PetRover/board/README.md

# board
This repo is for keeping track of our board file

Final implementation video can be found on YouTube! 
https://youtu.be/edSjpHhAPHc
