PetRover/board/(threads)

Thread 1 (2015-09-12):

Footprint is wrong for TPS55340

brycedcarter, 2015-09-12:
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

nnewhart, 2015-09-12:
done

Closed 2015-09-12.

Thread 2 (2015-09-12):

Add power pad to TPS55340

brycedcarter, 2015-09-12:
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

nnewhart, 2015-09-12:
I remember seeing this when I was making the footprint, but wasn't sure what to connect the pad to? Is it not connected to anything? or is it exposed ground?

brycedcarter, 2015-09-12:
yes, it should be connected to AGND... but that can happen during layout. For the footprint itself, you just need to make a solder mask defined pad where the underlying copper is 5X3.4 and the exposed copper is 2.31X2.64

brycedcarter, 2015-09-12:
[here](http://eagle.support.eng.narkive.com/FxgvYbra/how-do-i-do-a-solder-mask-defined-pad-with-eagle) is a link for how to do solder mask defined pads

brycedcarter, 2015-09-19:
Done
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

Closed 2015-09-19.

Thread 4 (2015-09-12):

Choose Inductor and Diode for TPS55340 (12V0 Boost)

brycedcarter, 2015-09-12:
use pages 15-18 in the datasheet
 requirements:
- 4.5 A output current
- 12 V output voltage
- 250 mV max ripple
- 3v min input voltage
- Expected transient ??? (need to do research and testing on the motors https://github.com/PetRover/board/issues/5)

Closed 2015-09-22.

Thread 5 (2015-09-12):

Determine Transient Load Expected from Motors

brycedcarter, 2015-09-12:
Need to test motors in the lab to determine inrush current

How much can we mitigate inrush current with PWM ramped startup?
How much can we mitigate inrush current with bulk cap?

brycedcarter, 2015-09-12:
- Unloaded startup current max = **500mA**
- unloaded operating current = **100mA**
- Stall current = **1.86A**

brycedcarter, 2015-09-24:
done

Closed 2015-09-24.

Thread 7 (2015-09-12):

Motor drivers need solder mask defined pads for their power pads

brycedcarter, 2015-09-12:
[here](http://eagle.support.eng.narkive.com/FxgvYbra/how-do-i-do-a-solder-mask-defined-pad-with-eagle) is a link for how to do solder mask defined pads

brycedcarter, 2015-09-19:
Done
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

Closed 2015-09-19.

Thread 12 (2015-09-17):

STOQ023251 not wide enough

ajbezreh, 2015-09-17:
New to this software, but I think the center of the pin to the outside of the package should be 2.6mm, and it's far less than that.
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

In the image below, the grid is set to 2.6mm (my way of showing that it's not wide enough?
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

ajbezreh, 2015-09-17:
Also, does it need to be 9.2mm in the other direction? It's currently 2.4mm.
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
Not sure if these dimensions mattered, but I figured it might change spacings on the board if they're actually different.

ajbezreh, 2015-09-17:
If it is an issue, then it's also an issue with the 4 pin connector
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

brycedcarter, 2015-09-20:
fixed

Closed 2015-09-20.

Thread 13 (2015-09-17):

Spacing too small on DEA202450BT-1294C1-H

ajbezreh, 2015-09-17:
Still might be doing this wrong, but I read this as the spacing should be 0.25mm

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

and in ours, it's definitely not that big (I made the grid 0.25mm, and a grid square is definitely bigger than the gap)

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

brycedcarter, 2015-09-20:
fixed

Closed 2015-09-20.

Thread 19 (2015-09-19):

Fix bad GND current path for stepper driver

brycedcarter, 2015-09-19:
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

brycedcarter, 2015-09-24:
done
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

Closed 2015-09-24.

Thread 21 (2015-09-22):

Pin numbers need changing for BBB

ajbezreh, 2015-09-22:
They are numbered pretty weird on the BBB

brycedcarter, 2015-10-01:
confirmed fixed

Closed 2015-10-01.

Thread 23 (2015-10-01):

Need to connect the MTR_CAM_AIN1 and 2 to something

brycedcarter, 2015-10-01:
were we going to join them with the treat motor PWM?

brycedcarter, 2015-10-03:
done

brycedcarter, 2015-10-03:
connected to MTR_TREAT_IN1 and MTR_TREAT_IN2

Closed 2015-10-03.

Thread 24 (2015-10-01):

The board is going to crash into the ethernet module

brycedcarter, 2015-10-01:
There is not really anything we can do about this. My suggestion is that we buy an extra set of headers so we have some extra standoff distance

brycedcarter, 2015-12-01:
yep...

Closed 2015-12-01.

Thread 29 (2015-11-06):

Board does not boot when connected to P8

nnewhart, 2015-11-06:
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

I measured the voltages of the P8 pins and there were a couple (44, 42) with a voltage of 1.7ish. I chose to investigate since it is below the 2V threshold. I measured the pull up resistances (R65, 66, 67, 68 on the back side of the bbb) when connected to the rover board and not connected. Not connected: all were around 83kohms. Connected one was 90ish k and 3 were around 52k. I forgot to write down which were which. My current thought is maybe we have resistances in parallel to these pullups causing the resistance to decrease and the voltage drops therefore not triggering correctly? Not sure if this is a valid assumption since I'm not positive what they should be doing.

Before all of that I tried pull downs on those pins... DO NOT do that haha all four blue boot pins lit up and stayed lit but it made a screeching warning noise... my bad... but I'm confident that didn't harm anything.

Another thing I investigated was the various rails and regulators. Most looked good, however, the 12V0_SW looked a little funky coming out of the inductor. Once again, I should have taken a picture. But the output of the reg looked fine so I don't think it was a problem.

Not sure how to proceed. If we think the pull up resistances could be the problem, we could try replacing them with something greater? Just wanted to recap my steps to avoid repetition.

nnewhart, 2015-12-02:
done. pulled up r44,42,41

Closed 2015-12-02.

Thread 34 (2015-12-01):

Even without board attached, BBB only boots every few times

ajbezreh, 2015-12-01:
Currently have to plug it in to 5V supply (wall wart) multiple times with button pressed for it to boot (any of the four LEDS to turn on)
