PetRover/board/ROVER_PCB.brd

## EAGLE design ROVER_PCB.brd (2015-10-28)

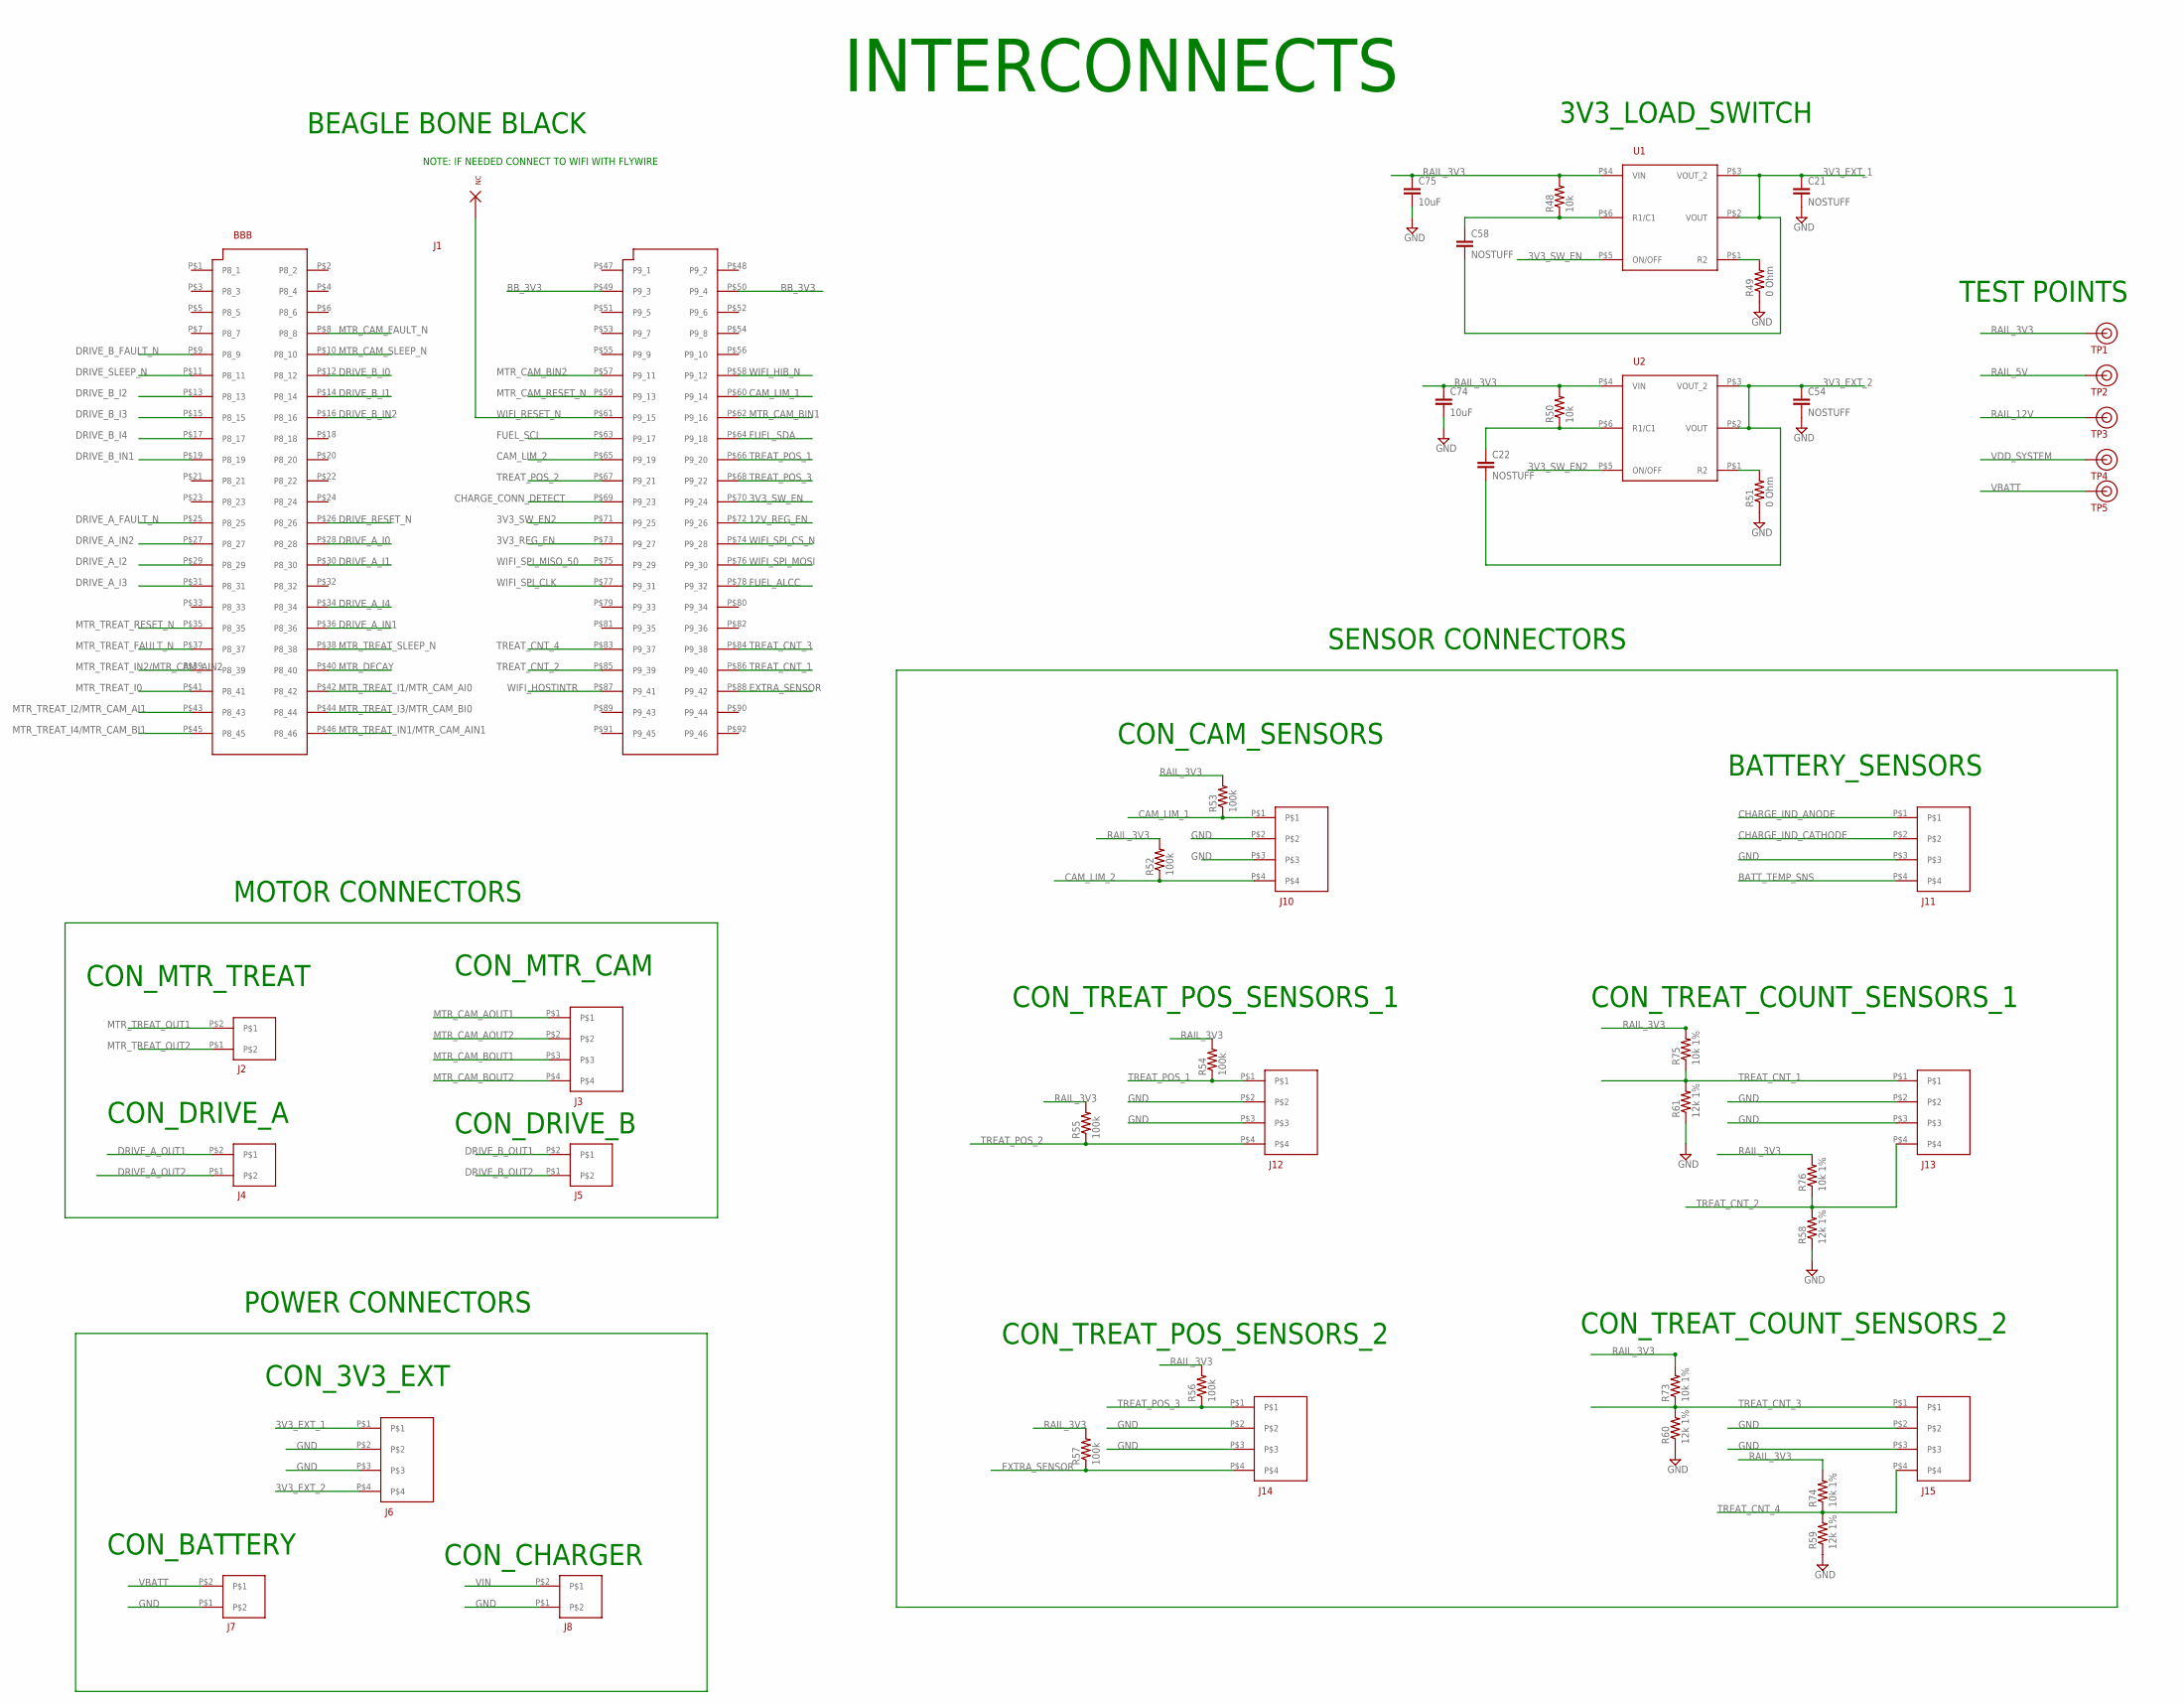
[picture p5: schematic ROVER_PCB.sch, sheet 1]

Parts:
C21, C22, C54, C58: NOSTUFF; C0402
C74, C75: 10uF; C0402
J1: NONE; BBB
J2, J4, J5, J7, J8: 2PIN_OST_3251
J3: 4PIN_OST_3251
J6, J10, J11, J12, J13, J14, J15: 4PIN_JST
R48, R50: 10k; R0603
R49, R51: 0 Ohm; R0603
R52, R53, R54, R55, R56, R57: 100k; R0603
R58, R59, R60, R61: 12k 1%; R0603
R73, R74, R75, R76: 10k 1%; R0603
TP1, TP2, TP3, TP4, TP5: TEST_POINT
U1, U2: TPS27081A

Connections:
3V3_EXT_1: C21.1, C58.2, J6.P$1, U1.P$2 (VOUT), U1.P$3 (VOUT_2)
3V3_EXT_2: C22.2, C54.1, J6.P$4, U2.P$2 (VOUT), U2.P$3 (VOUT_2)
3V3_REG_EN: J1.P$73 (P9_27); also elsewhere on the board
3V3_SW_EN: J1.P$70 (P9_24), U1.P$5 (ON/OFF)
3V3_SW_EN2: J1.P$71 (P9_25), U2.P$5 (ON/OFF)
12V_REG_EN: J1.P$72 (P9_26); also elsewhere on the board
BATT_TEMP_SNS: J11.P$4; also elsewhere on the board
BB_3V3: J1.P$49 (P9_3), J1.P$50 (P9_4); also elsewhere on the board
CAM_LIM_1: J1.P$60 (P9_14), J10.P$1, R53.1
CAM_LIM_2: J1.P$65 (P9_19), J10.P$4, R52.1
CHARGE_CONN_DETECT: J1.P$69 (P9_23); also elsewhere on the board
CHARGE_IND_ANODE: J11.P$1; also elsewhere on the board
CHARGE_IND_CATHODE: J11.P$2; also elsewhere on the board
DRIVE_A_FAULT_N: J1.P$25 (P8_25); also elsewhere on the board
DRIVE_A_I0: J1.P$28 (P8_28); also elsewhere on the board
DRIVE_A_I1: J1.P$30 (P8_30); also elsewhere on the board
DRIVE_A_I2: J1.P$29 (P8_29); also elsewhere on the board
DRIVE_A_I3: J1.P$31 (P8_31); also elsewhere on the board
DRIVE_A_I4: J1.P$34 (P8_34); also elsewhere on the board
DRIVE_A_IN1: J1.P$36 (P8_36); also elsewhere on the board
DRIVE_A_IN2: J1.P$27 (P8_27); also elsewhere on the board
DRIVE_A_OUT1: J4.P$2; also elsewhere on the board
DRIVE_A_OUT2: J4.P$1; also elsewhere on the board
DRIVE_B_FAULT_N: J1.P$9 (P8_9); also elsewhere on the board
DRIVE_B_I0: J1.P$12 (P8_12); also elsewhere on the board
DRIVE_B_I1: J1.P$14 (P8_14); also elsewhere on the board
DRIVE_B_I2: J1.P$13 (P8_13); also elsewhere on the board
DRIVE_B_I3: J1.P$15 (P8_15); also elsewhere on the board
DRIVE_B_I4: J1.P$17 (P8_17); also elsewhere on the board
DRIVE_B_IN1: J1.P$19 (P8_19); also elsewhere on the board
DRIVE_B_IN2: J1.P$16 (P8_16); also elsewhere on the board
DRIVE_B_OUT1: J5.P$2; also elsewhere on the board
DRIVE_B_OUT2: J5.P$1; also elsewhere on the board
DRIVE_RESET_N: J1.P$26 (P8_26); also elsewhere on the board
DRIVE_SLEEP_N: J1.P$11 (P8_11); also elsewhere on the board
EXTRA_SENSOR: J1.P$88 (P9_42), J14.P$4, R57.1
FUEL_ALCC: J1.P$78 (P9_32); also elsewhere on the board
FUEL_SCL: J1.P$63 (P9_17); also elsewhere on the board
FUEL_SDA: J1.P$64 (P9_18); also elsewhere on the board
GND: C21.2, C54.2, C74.2, C75.2, J6.P$2, J6.P$3, J7.P$1, J8.P$1, J10.P$2, J10.P$3, J11.P$3, J12.P$2, J12.P$3, J13.P$2, J13.P$3, J14.P$2, J14.P$3, J15.P$2, J15.P$3, R49.1, R51.1, R58.1, R59.1, R60.1, R61.1; also elsewhere on the board
MTR_CAM_AOUT1: J3.P$1; also elsewhere on the board
MTR_CAM_AOUT2: J3.P$2; also elsewhere on the board
MTR_CAM_BIN1: J1.P$62 (P9_16); also elsewhere on the board
MTR_CAM_BIN2: J1.P$57 (P9_11); also elsewhere on the board
MTR_CAM_BOUT1: J3.P$3; also elsewhere on the board
MTR_CAM_BOUT2: J3.P$4; also elsewhere on the board
MTR_CAM_FAULT_N: J1.P$8 (P8_8); also elsewhere on the board
MTR_CAM_RESET_N: J1.P$59 (P9_13); also elsewhere on the board
MTR_CAM_SLEEP_N: J1.P$10 (P8_10); also elsewhere on the board
MTR_DECAY: J1.P$40 (P8_40); also elsewhere on the board
MTR_TREAT_FAULT_N: J1.P$37 (P8_37); also elsewhere on the board
MTR_TREAT_I0: J1.P$41 (P8_41); also elsewhere on the board
MTR_TREAT_I1/MTR_CAM_AI0: J1.P$42 (P8_42); also elsewhere on the board
MTR_TREAT_I2/MTR_CAM_AI1: J1.P$43 (P8_43); also elsewhere on the board
MTR_TREAT_I3/MTR_CAM_BI0: J1.P$44 (P8_44); also elsewhere on the board
MTR_TREAT_I4/MTR_CAM_BI1: J1.P$45 (P8_45); also elsewhere on the board
MTR_TREAT_IN1/MTR_CAM_AIN1: J1.P$46 (P8_46); also elsewhere on the board
MTR_TREAT_IN2/MTR_CAM_AIN2: J1.P$39 (P8_39); also elsewhere on the board
MTR_TREAT_OUT1: J2.P$2; also elsewhere on the board
MTR_TREAT_OUT2: J2.P$1; also elsewhere on the board
MTR_TREAT_RESET_N: J1.P$35 (P8_35); also elsewhere on the board
MTR_TREAT_SLEEP_N: J1.P$38 (P8_38); also elsewhere on the board
unnamed: R49.2, U1.P$1 (R2)
unnamed: R51.2, U2.P$1 (R2)
unnamed: C58.1, R48.1, U1.P$6 (R1/C1)
unnamed: C22.1, R50.1, U2.P$6 (R1/C1)
RAIL_3V3: C74.1, C75.1, R48.2, R50.2, R52.2, R53.2, R54.2, R55.2, R56.2, R57.2, R73.2, R74.2, R75.2, R76.2, TP1.P$1, U1.P$4 (VIN), U2.P$4 (VIN); also elsewhere on the board
RAIL_5V: TP2.P$1; also elsewhere on the board
RAIL_12V: TP3.P$1; also elsewhere on the board
TREAT_CNT_1: J1.P$86 (P9_40), J13.P$1, R61.2, R75.1
TREAT_CNT_2: J1.P$85 (P9_39), J13.P$4, R58.2, R76.1
TREAT_CNT_3: J1.P$84 (P9_38), J15.P$1, R60.2, R73.1
TREAT_CNT_4: J1.P$83 (P9_37), J15.P$4, R59.2, R74.1
TREAT_POS_1: J1.P$66 (P9_20), J12.P$1, R54.1
TREAT_POS_2: J1.P$67 (P9_21), J12.P$4, R55.1
TREAT_POS_3: J1.P$68 (P9_22), J14.P$1, R56.1
VBATT: J7.P$2, TP5.P$1; also elsewhere on the board
VDD_SYSTEM: TP4.P$1; also elsewhere on the board
VIN: J8.P$2; also elsewhere on the board
WIFI_HIB_N: J1.P$58 (P9_12); also elsewhere on the board
WIFI_HOSTINTR: J1.P$87 (P9_41); also elsewhere on the board
WIFI_RESET_N: J1.P$61 (P9_15)
WIFI_SPI_CLK: J1.P$77 (P9_31); also elsewhere on the board
WIFI_SPI_CS_N: J1.P$74 (P9_28); also elsewhere on the board
WIFI_SPI_MISO_50: J1.P$75 (P9_29); also elsewhere on the board
WIFI_SPI_MOSI: J1.P$76 (P9_30); also elsewhere on the board

Notes on the sheet:
BEAGLE BONE BLACK
CON_BATTERY
CON_CHARGER
CON_DRIVE_A
CON_DRIVE_B
CON_MTR_TREAT
CON_MTR_CAM
CON_CAM_SENSORS
CON_TREAT_POS_SENSORS_1
CON_TREAT_POS_SENSORS_2
CON_TREAT_COUNT_SENSORS_2
CON_TREAT_COUNT_SENSORS_1
CON_3V3_EXT
3V3_LOAD_SWITCH
NOTE: IF NEEDED CONNECT TO WIFI WITH FLYWIRE
TEST POINTS
BATTERY_SENSORS
INTERCONNECTS
POWER CONNECTORS
MOTOR CONNECTORS
SENSOR CONNECTORS

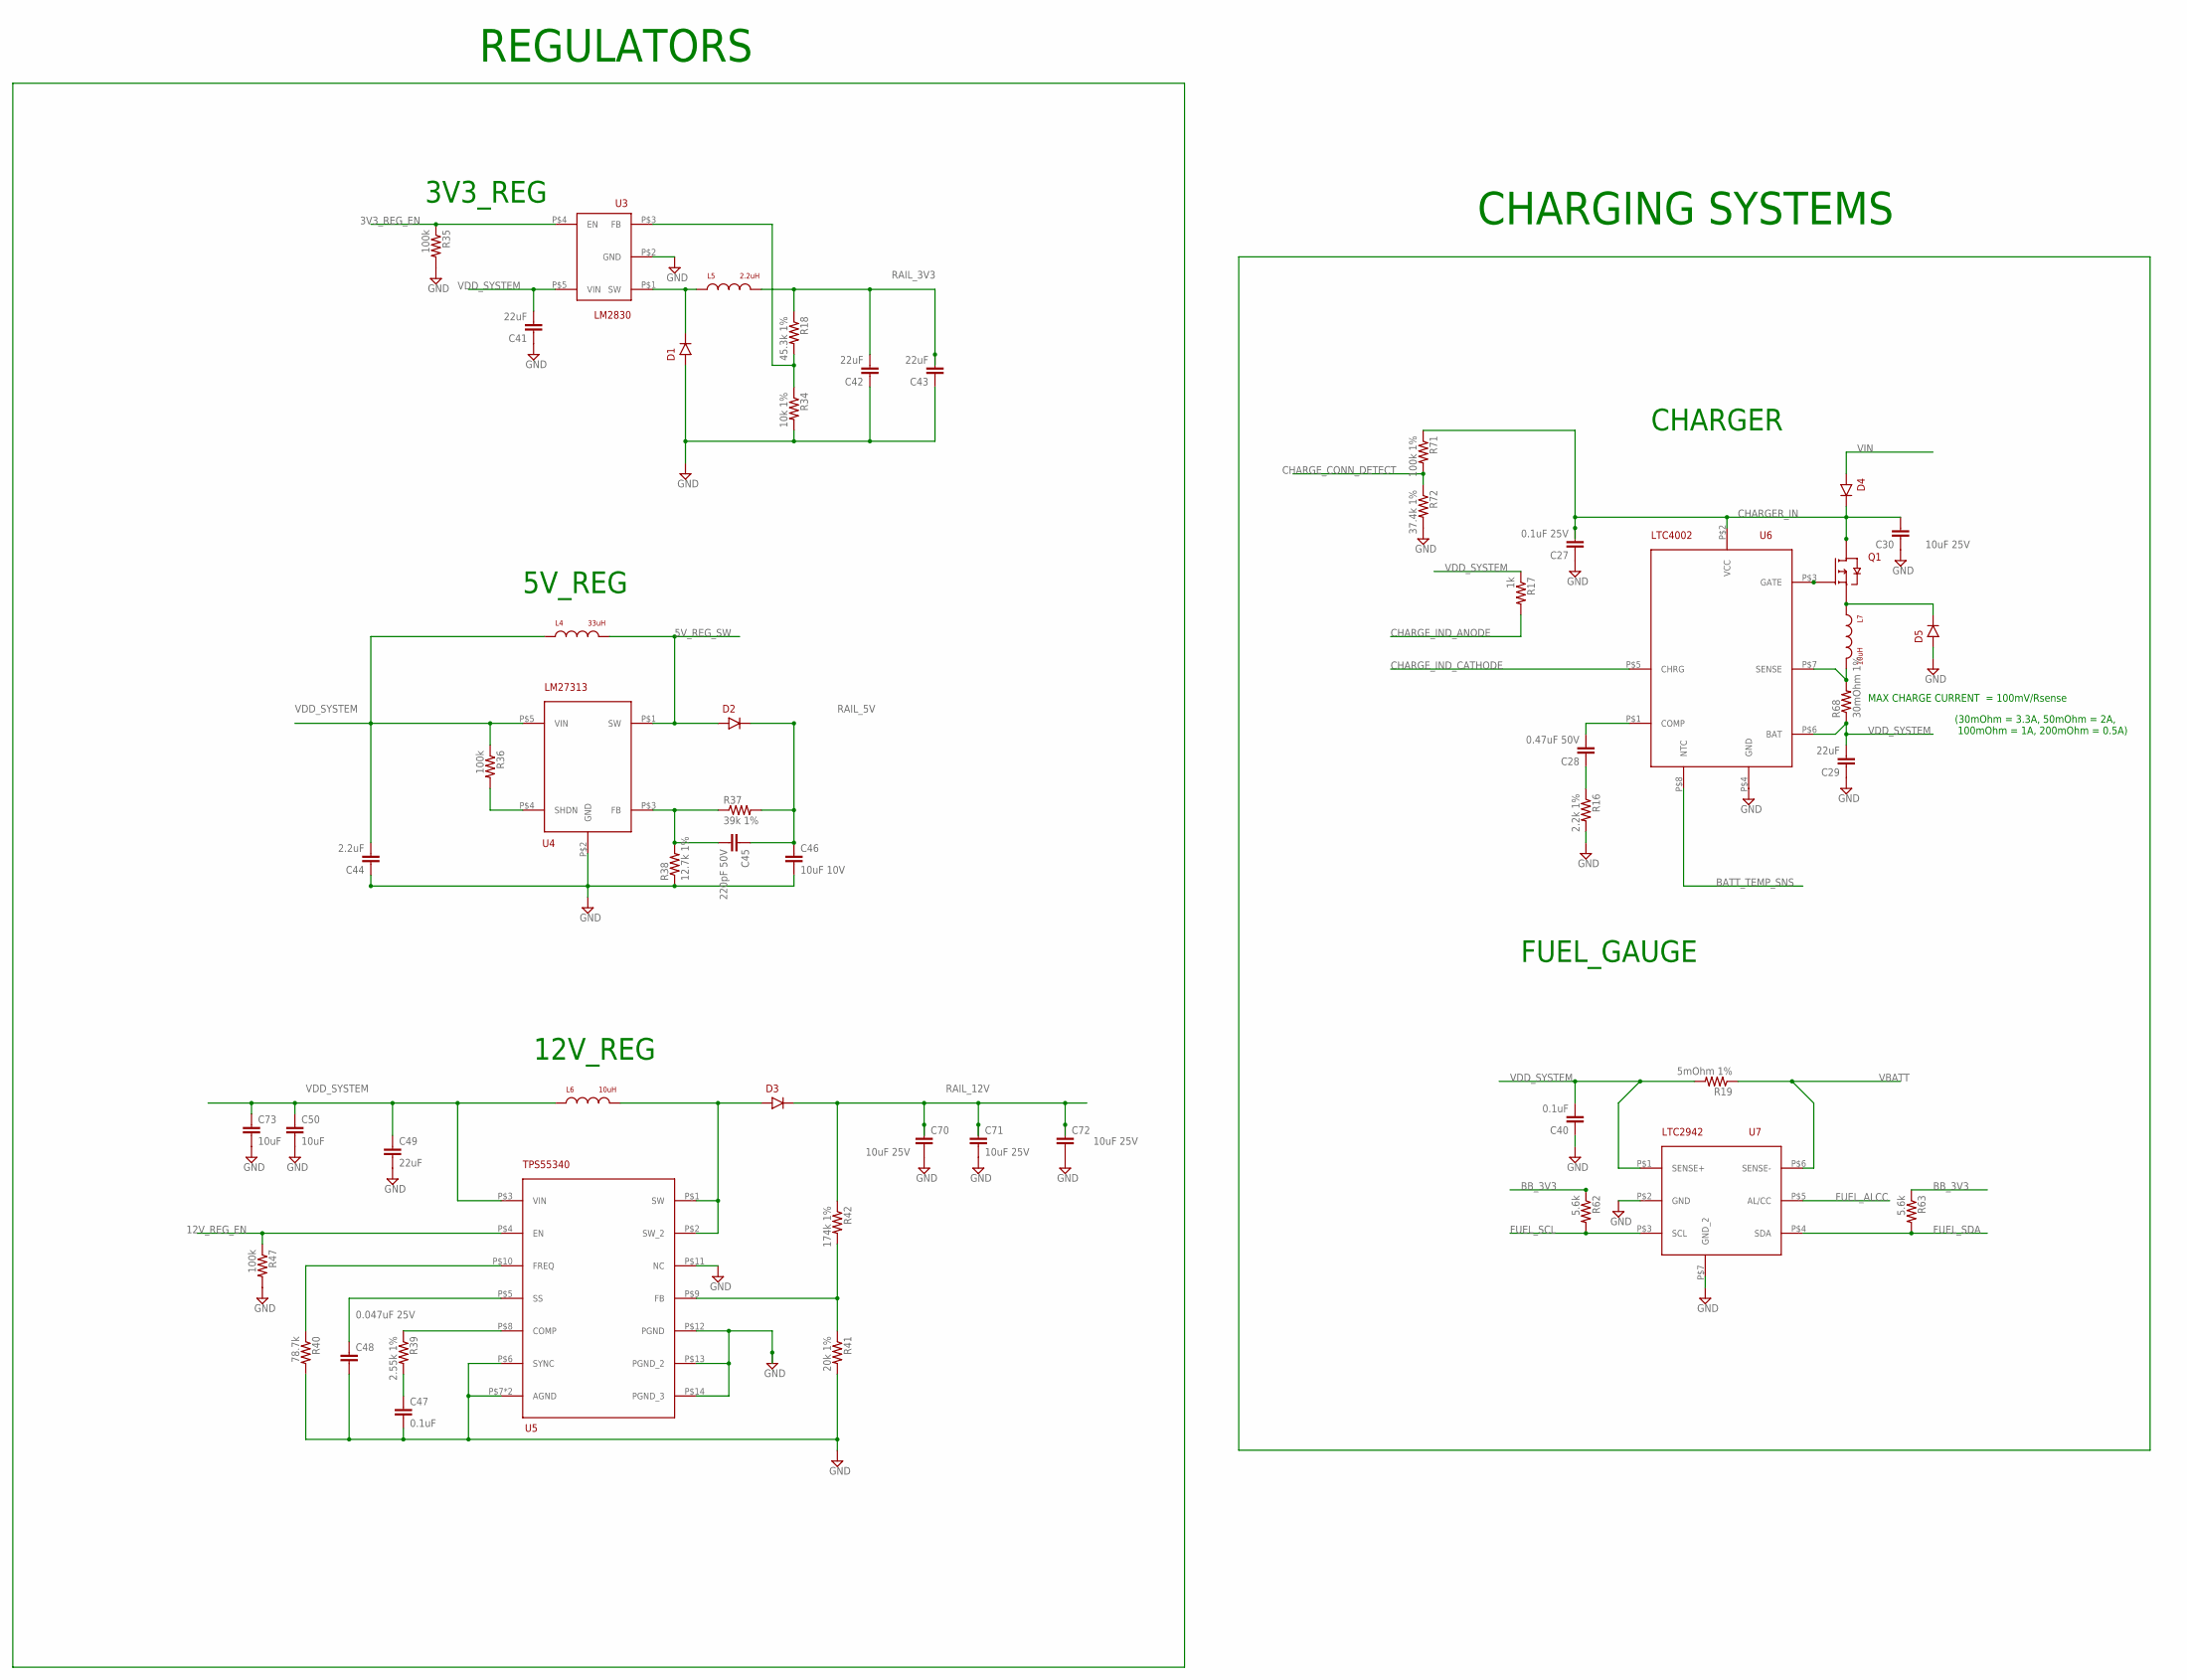
[picture p6: schematic ROVER_PCB.sch, sheet 2]

Parts:
C27: 0.1uF 25V; C0603
C28: 0.47uF 50V; C0603
C29, C41, C42, C43, C49: 22uF; C0603
C30, C70, C71, C72: 10uF 25V; C0603
C40, C47: 0.1uF; C0603
C44: 2.2uF; C0603
C45: 220pF 50V; C0603
C46: 10uF 10V; C0603
C48: 0.047uF 25V; C0603
C50, C73: 10uF; C0402
D1: CRS08
D2: MBR0520; MBR05XX
D3, D4, D5: B540C
L4: 33uH; AIUR-03
L5: 2.2uH; B82144B2222K
L6, L7: 10uH; ASPI-0630LR
Q1: AO3407A; SOT23
R16: 2.2k 1%; R0603
R17: 1k; R0603
R18: 45.3k 1%; R0603
R19: 5mOhm 1%; R2512
R34: 10k 1%; R0603
R35, R36, R47: 100k; R0603
R37: 39k 1%; R0603
R38: 12.7k 1%; R0603
R39: 2.55k 1%; R0603
R40: 78.7k; R0603
R41: 20k 1%; R0402
R42: 174k 1%; R0402
R62, R63: 5.6k; R0603
R68: 30mOhm 1%; R2512
R71: 100k 1%; R0603
R72: 37.4k 1%; R0603
U3: LM2830
U4: LM27313; LM2830
U5: TPS55340
U6: LTC4002
U7: LTC2942

Connections:
3V3_REG_EN: R35.1, U3.P$4 (EN); also elsewhere on the board
3V3_SW: D1.P$2, L5.P$1, U3.P$1 (SW)
5V_REG_SW: D2.P$1, L4.P$2, U4.P$1 (SW)
12V0_SW: D3.P$1, L6.P$2, U5.P$1 (SW), U5.P$2 (SW_2)
12V_REG_EN: R47.1, U5.P$4 (EN); also elsewhere on the board
BATT_TEMP_SNS: U6.P$8 (NTC); also elsewhere on the board
BB_3V3: R62.1, R63.1; also elsewhere on the board
CATCH_DIODE_CATHODE: D5.P$2, L7.P$1, Q1.2 (SOURE)
CHARGER_IN: C27.2, C30.2, D4.P$2, Q1.3 (DRAIN), R71.1, U6.P$2 (VCC)
CHARGE_CONN_DETECT: R71.2, R72.1; also elsewhere on the board
CHARGE_IND_ANODE: R17.2; also elsewhere on the board
CHARGE_IND_CATHODE: U6.P$5 (CHRG); also elsewhere on the board
CHARGE_SENSE_HI_SIDE: L7.P$2, R68.2, U6.P$7 (SENSE)
FUEL_ALCC: U7.P$5 (AL/CC); also elsewhere on the board
FUEL_SCL: R62.2, U7.P$3 (SCL); also elsewhere on the board
FUEL_SDA: R63.2, U7.P$4 (SDA); also elsewhere on the board
GND: C27.1, C29.1, C30.1, C40.1, C41.1, C42.1, C43.1, C44.1, C46.2, C47.2, C48.2, C49.2, C50.2, C70.2, C71.2, C72.2, C73.2, D1.P$1, D5.P$1, R16.2, R34.2, R35.2, R38.1, R40.2, R41.2, R47.2, R72.2, U3.P$2 (GND), U4.P$2 (GND), U5.P$6 (SYNC), U5.P$7 (AGND), U5.P$11 (NC), U5.P$12 (PGND), U5.P$13 (PGND_2), U5.P$14 (PGND_3), U5.P$15 (AGND), U6.P$4 (GND), U7.P$2 (GND), U7.P$7 (GND_2); also elsewhere on the board
unnamed: Q1.1 (GATE), U6.P$3 (GATE)
unnamed: C28.1, R16.1
unnamed: C28.2, U6.P$1 (COMP)
unnamed: R18.2, R34.1, U3.P$3 (FB)
unnamed: R39.1, U5.P$8 (COMP)
unnamed: C47.1, R39.2
unnamed: C48.1, U5.P$5 (SS)
unnamed: C45.2, R37.1, R38.2, U4.P$3 (FB)
unnamed: R40.1, U5.P$10 (FREQ)
unnamed: R41.1, R42.2, U5.P$9 (FB)
unnamed: R36.2, U4.P$4 (SHDN)
RAIL_3V3: C42.2, C43.2, L5.P$2, R18.1; also elsewhere on the board
RAIL_5V: C45.1, C46.1, D2.P$2, R37.2; also elsewhere on the board
RAIL_12V: C70.1, C71.1, C72.1, D3.P$2, R42.1; also elsewhere on the board
VBATT: R19.1, U7.P$6 (SENSE-); also elsewhere on the board
VDD_SYSTEM: C29.2, C40.2, C41.2, C44.2, C49.1, C50.1, C73.1, L4.P$1, L6.P$1, R17.1, R19.2, R36.1, R68.1, U3.P$5 (VIN), U4.P$5 (VIN), U5.P$3 (VIN), U6.P$6 (BAT), U7.P$1 (SENSE+); also elsewhere on the board
VIN: D4.P$1; also elsewhere on the board

Notes on the sheet:
3V3_REG
5V_REG
12V_REG
CHARGER
FUEL_GAUGE
MAX CHARGE CURRENT = 100mV/Rsense
REGULATORS
CHARGING SYSTEMS
(30mOhm = 3.3A, 50mOhm = 2A, 100mOhm = 1A, 200mOhm = 0.5A)

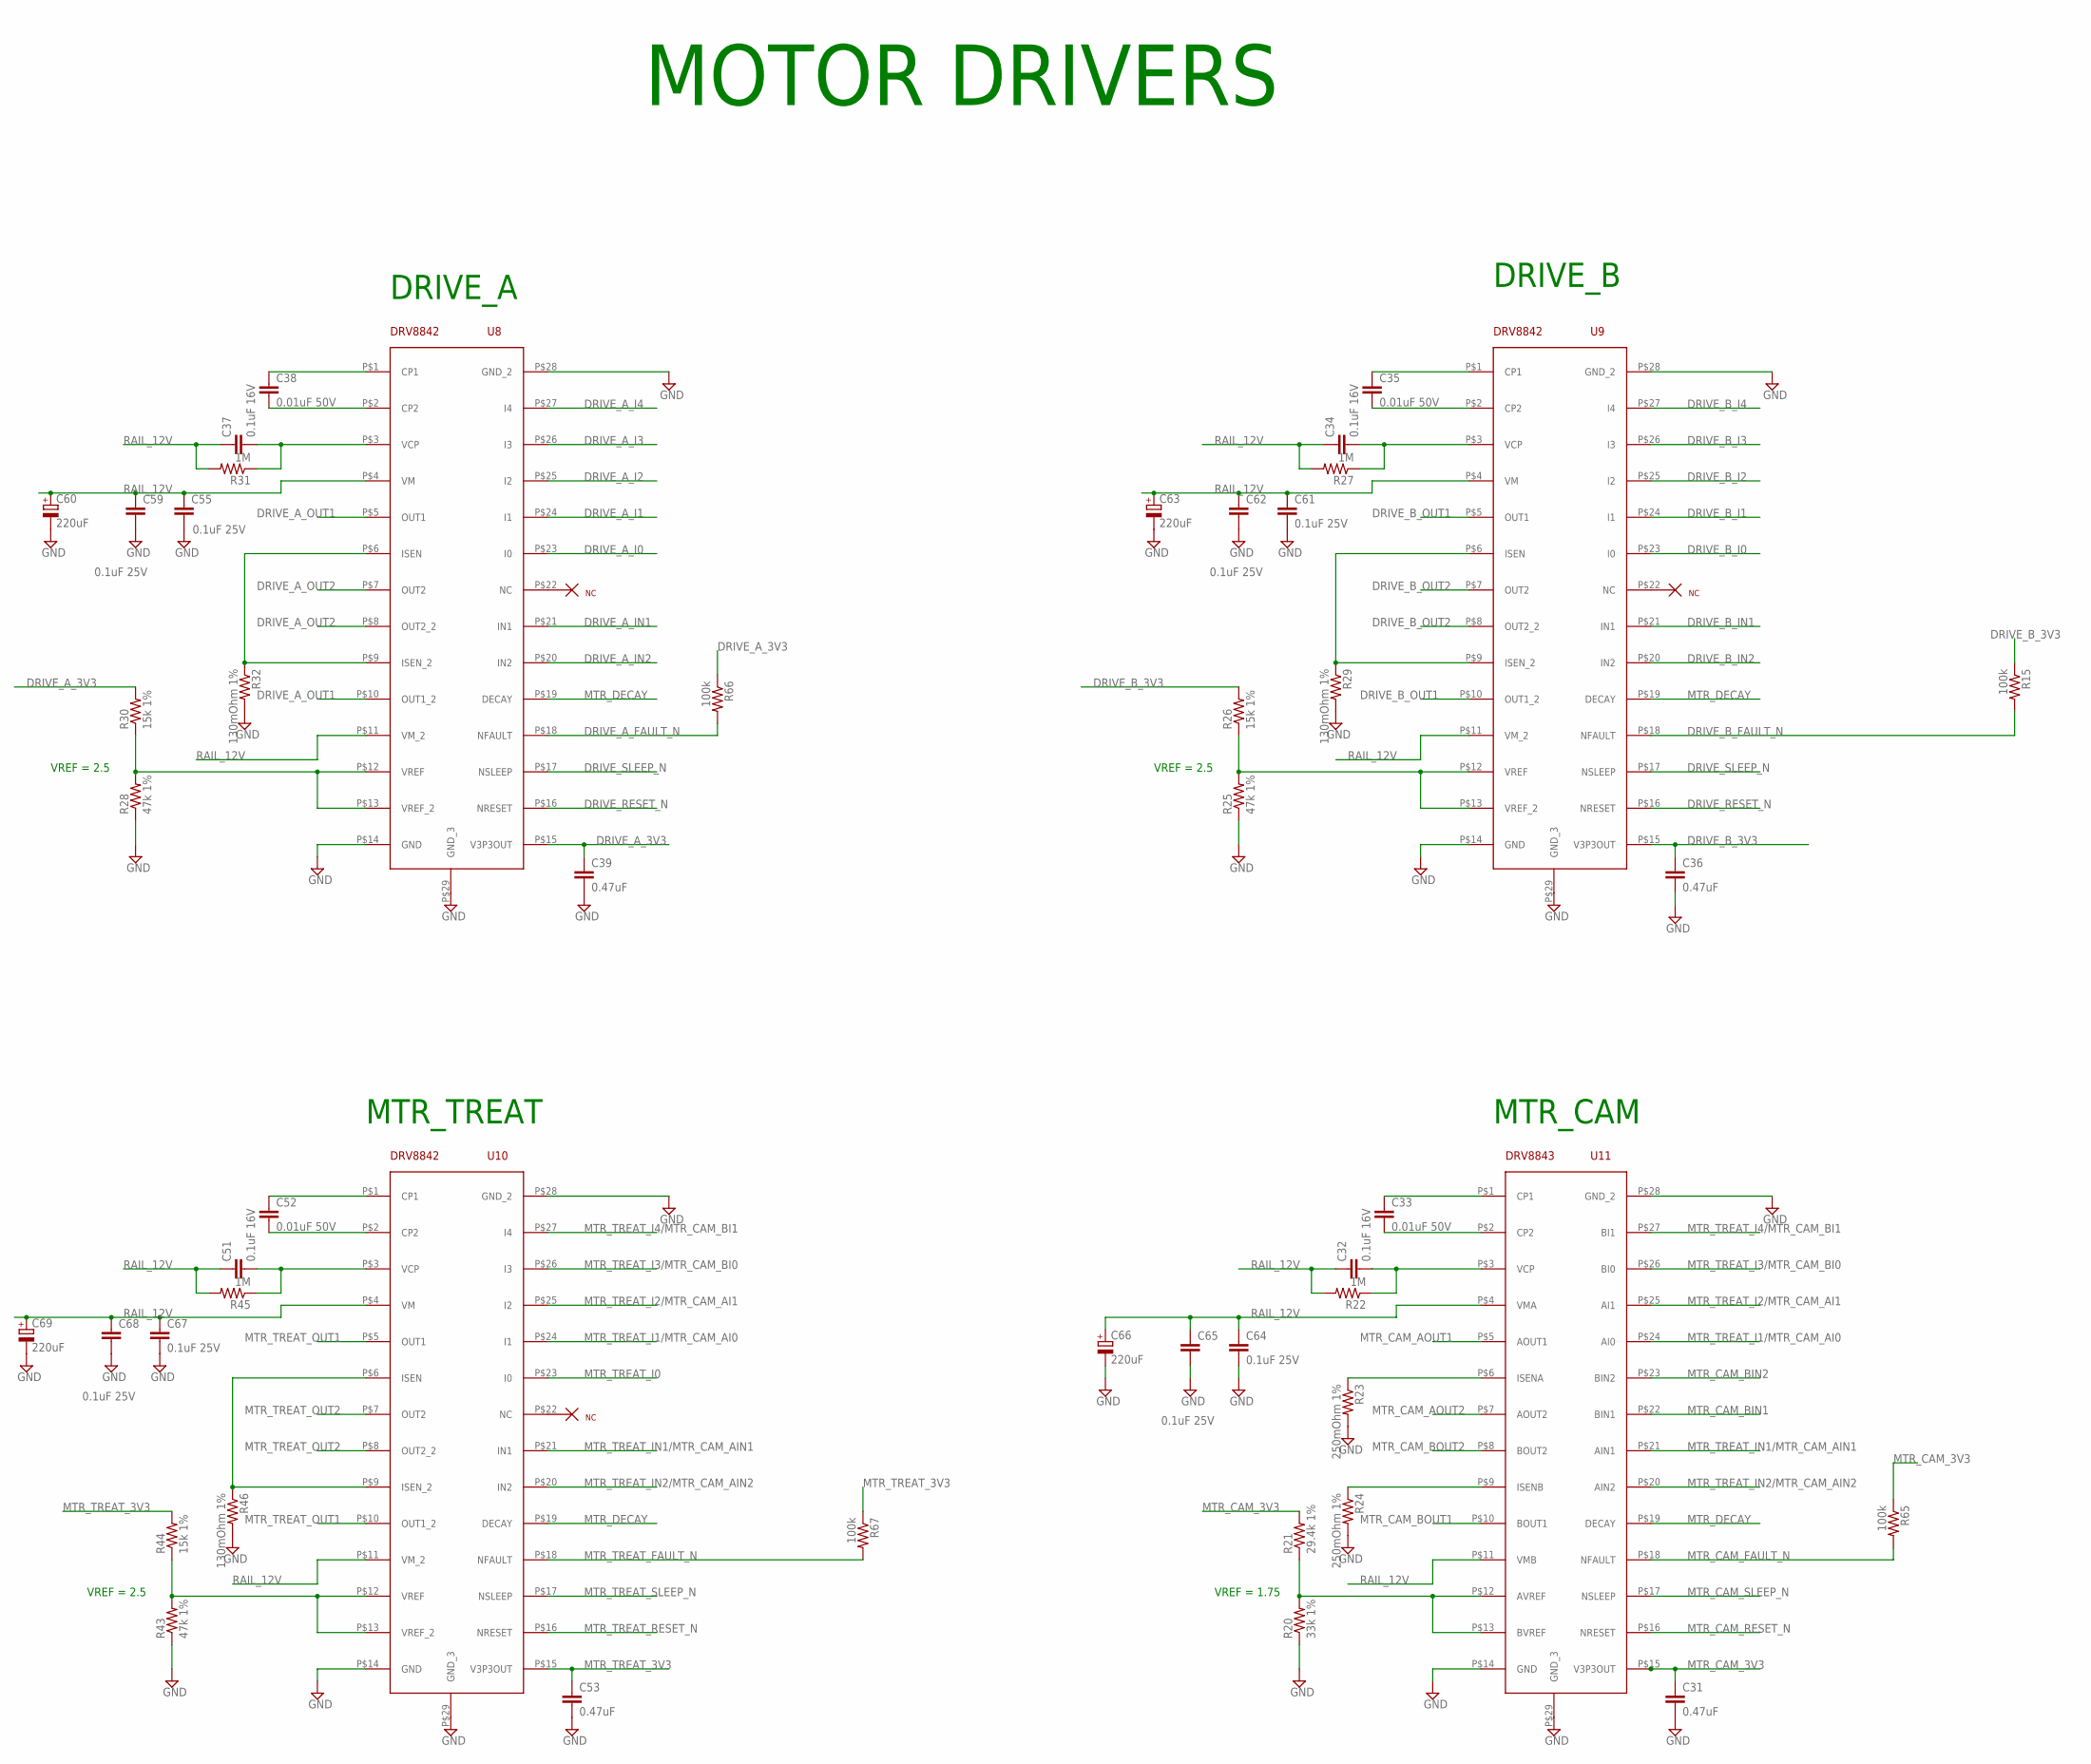
[picture p7: schematic ROVER_PCB.sch, sheet 3]

Parts:
C31, C36, C39, C53: 0.47uF; C0402
C32, C34, C37, C51: 0.1uF 16V; C0402
C33, C35, C38, C52: 0.01uF 50V; C0402
C55, C59, C61, C62, C64, C65, C67, C68: 0.1uF 25V; C0402
C60, C63, C66, C69: 220uF; E5-6
R15, R65, R66, R67: 100k; R0402
R20: 33k 1%; R0402
R21: 29.4k 1%; R0402
R22, R27, R31, R45: 1M; R0402
R23, R24: 250mOhm 1%; R1206
R25, R28, R43: 47k 1%; R0402
R26, R30, R44: 15k 1%; R0402
R29, R32, R46: 130mOhm 1%; R2512
U8, U9, U10: DRV8842
U11: DRV8843; DRV8842

Connections:
DRIVE_A_3V3: C39.1, R30.2, R66.1, U8.P$15 (V3P3OUT)
DRIVE_A_FAULT_N: R66.2, U8.P$18 (NFAULT); also elsewhere on the board
DRIVE_A_I0: U8.P$23 (I0); also elsewhere on the board
DRIVE_A_I1: U8.P$24 (I1); also elsewhere on the board
DRIVE_A_I2: U8.P$25 (I2); also elsewhere on the board
DRIVE_A_I3: U8.P$26 (I3); also elsewhere on the board
DRIVE_A_I4: U8.P$27 (I4); also elsewhere on the board
DRIVE_A_IN1: U8.P$21 (IN1); also elsewhere on the board
DRIVE_A_IN2: U8.P$20 (IN2); also elsewhere on the board
DRIVE_A_OUT1: U8.P$5 (OUT1), U8.P$10 (OUT1_2); also elsewhere on the board
DRIVE_A_OUT2: U8.P$7 (OUT2), U8.P$8 (OUT2_2); also elsewhere on the board
DRIVE_B_3V3: C36.1, R15.1, R26.2, U9.P$15 (V3P3OUT)
DRIVE_B_FAULT_N: R15.2, U9.P$18 (NFAULT); also elsewhere on the board
DRIVE_B_I0: U9.P$23 (I0); also elsewhere on the board
DRIVE_B_I1: U9.P$24 (I1); also elsewhere on the board
DRIVE_B_I2: U9.P$25 (I2); also elsewhere on the board
DRIVE_B_I3: U9.P$26 (I3); also elsewhere on the board
DRIVE_B_I4: U9.P$27 (I4); also elsewhere on the board
DRIVE_B_IN1: U9.P$21 (IN1); also elsewhere on the board
DRIVE_B_IN2: U9.P$20 (IN2); also elsewhere on the board
DRIVE_B_OUT1: U9.P$5 (OUT1), U9.P$10 (OUT1_2); also elsewhere on the board
DRIVE_B_OUT2: U9.P$7 (OUT2), U9.P$8 (OUT2_2); also elsewhere on the board
DRIVE_RESET_N: U8.P$16 (NRESET), U9.P$16 (NRESET); also elsewhere on the board
DRIVE_SLEEP_N: U8.P$17 (NSLEEP), U9.P$17 (NSLEEP); also elsewhere on the board
GND: C31.2, C36.2, C39.2, C53.2, C55.2, C59.2, C60.-, C61.2, C62.2, C63.-, C64.2, C65.2, C66.-, C67.2, C68.2, C69.-, R20.1, R23.2, R24.2, R25.1, R28.1, R29.2, R32.2, R43.1, R46.2, U8.P$14 (GND), U8.P$28 (GND_2), U8.P$29 (GND_3), U9.P$14 (GND), U9.P$28 (GND_2), U9.P$29 (GND_3), U10.P$14 (GND), U10.P$28 (GND_2), U10.P$29 (GND_3), U11.P$14 (GND), U11.P$28 (GND_2), U11.P$29 (GND_3); also elsewhere on the board
MTR_CAM_3V3: C31.1, R21.2, R65.1, U11.P$15 (V3P3OUT)
MTR_CAM_AOUT1: U11.P$5 (AOUT1); also elsewhere on the board
MTR_CAM_AOUT2: U11.P$7 (AOUT2); also elsewhere on the board
MTR_CAM_BIN1: U11.P$22 (BIN1); also elsewhere on the board
MTR_CAM_BIN2: U11.P$23 (BIN2); also elsewhere on the board
MTR_CAM_BOUT1: U11.P$10 (BOUT1); also elsewhere on the board
MTR_CAM_BOUT2: U11.P$8 (BOUT2); also elsewhere on the board
MTR_CAM_FAULT_N: R65.2, U11.P$18 (NFAULT); also elsewhere on the board
MTR_CAM_RESET_N: U11.P$16 (NRESET); also elsewhere on the board
MTR_CAM_SLEEP_N: U11.P$17 (NSLEEP); also elsewhere on the board
MTR_DECAY: U8.P$19 (DECAY), U9.P$19 (DECAY), U10.P$19 (DECAY), U11.P$19 (DECAY); also elsewhere on the board
MTR_TREAT_3V3: C53.1, R44.2, R67.1, U10.P$15 (V3P3OUT)
MTR_TREAT_FAULT_N: R67.2, U10.P$18 (NFAULT); also elsewhere on the board
MTR_TREAT_I0: U10.P$23 (I0); also elsewhere on the board
MTR_TREAT_I1/MTR_CAM_AI0: U10.P$24 (I1), U11.P$24 (AI0); also elsewhere on the board
MTR_TREAT_I2/MTR_CAM_AI1: U10.P$25 (I2), U11.P$25 (AI1); also elsewhere on the board
MTR_TREAT_I3/MTR_CAM_BI0: U10.P$26 (I3), U11.P$26 (BI0); also elsewhere on the board
MTR_TREAT_I4/MTR_CAM_BI1: U10.P$27 (I4), U11.P$27 (BI1); also elsewhere on the board
MTR_TREAT_IN1/MTR_CAM_AIN1: U10.P$21 (IN1), U11.P$21 (AIN1); also elsewhere on the board
MTR_TREAT_IN2/MTR_CAM_AIN2: U10.P$20 (IN2), U11.P$20 (AIN2); also elsewhere on the board
MTR_TREAT_OUT1: U10.P$5 (OUT1), U10.P$10 (OUT1_2); also elsewhere on the board
MTR_TREAT_OUT2: U10.P$7 (OUT2), U10.P$8 (OUT2_2); also elsewhere on the board
MTR_TREAT_RESET_N: U10.P$16 (NRESET); also elsewhere on the board
MTR_TREAT_SLEEP_N: U10.P$17 (NSLEEP); also elsewhere on the board
unnamed: R43.2, R44.1, U10.P$12 (VREF), U10.P$13 (VREF_2)
unnamed: C52.1, U10.P$1 (CP1)
unnamed: C52.2, U10.P$2 (CP2)
unnamed: R46.1, U10.P$6 (ISEN), U10.P$9 (ISEN_2)
unnamed: C51.2, R45.1, U10.P$3 (VCP)
unnamed: R20.2, R21.1, U11.P$12 (AVREF), U11.P$13 (BVREF)
unnamed: C33.1, U11.P$1 (CP1)
unnamed: C33.2, U11.P$2 (CP2)
unnamed: R23.1, U11.P$6 (ISENA)
unnamed: R24.1, U11.P$9 (ISENB)
unnamed: C32.2, R22.1, U11.P$3 (VCP)
unnamed: R28.2, R30.1, U8.P$12 (VREF), U8.P$13 (VREF_2)
unnamed: R25.2, R26.1, U9.P$12 (VREF), U9.P$13 (VREF_2)
unnamed: C35.1, U9.P$1 (CP1)
unnamed: C35.2, U9.P$2 (CP2)
unnamed: R29.1, U9.P$6 (ISEN), U9.P$9 (ISEN_2)
unnamed: C38.1, U8.P$1 (CP1)
unnamed: C34.2, R27.1, U9.P$3 (VCP)
unnamed: C38.2, U8.P$2 (CP2)
unnamed: R32.1, U8.P$6 (ISEN), U8.P$9 (ISEN_2)
unnamed: C37.2, R31.1, U8.P$3 (VCP)
RAIL_12V: C32.1, C34.1, C37.1, C51.1, C55.1, C59.1, C60.+, C61.1, C62.1, C63.+, C64.1, C65.1, C66.+, C67.1, C68.1, C69.+, R22.2, R27.2, R31.2, R45.2, U8.P$4 (VM), U8.P$11 (VM_2), U9.P$4 (VM), U9.P$11 (VM_2), U10.P$4 (VM), U10.P$11 (VM_2), U11.P$4 (VMA), U11.P$11 (VMB); also elsewhere on the board

Notes on the sheet:
DRIVE_A
DRIVE_B
MTR_TREAT
MTR_CAM
MOTOR DRIVERS
VREF = 1.75
VREF = 2.5
