PetRover/board/ROVER_PCB.brd

## EAGLE design ROVER_PCB.brd (continued)

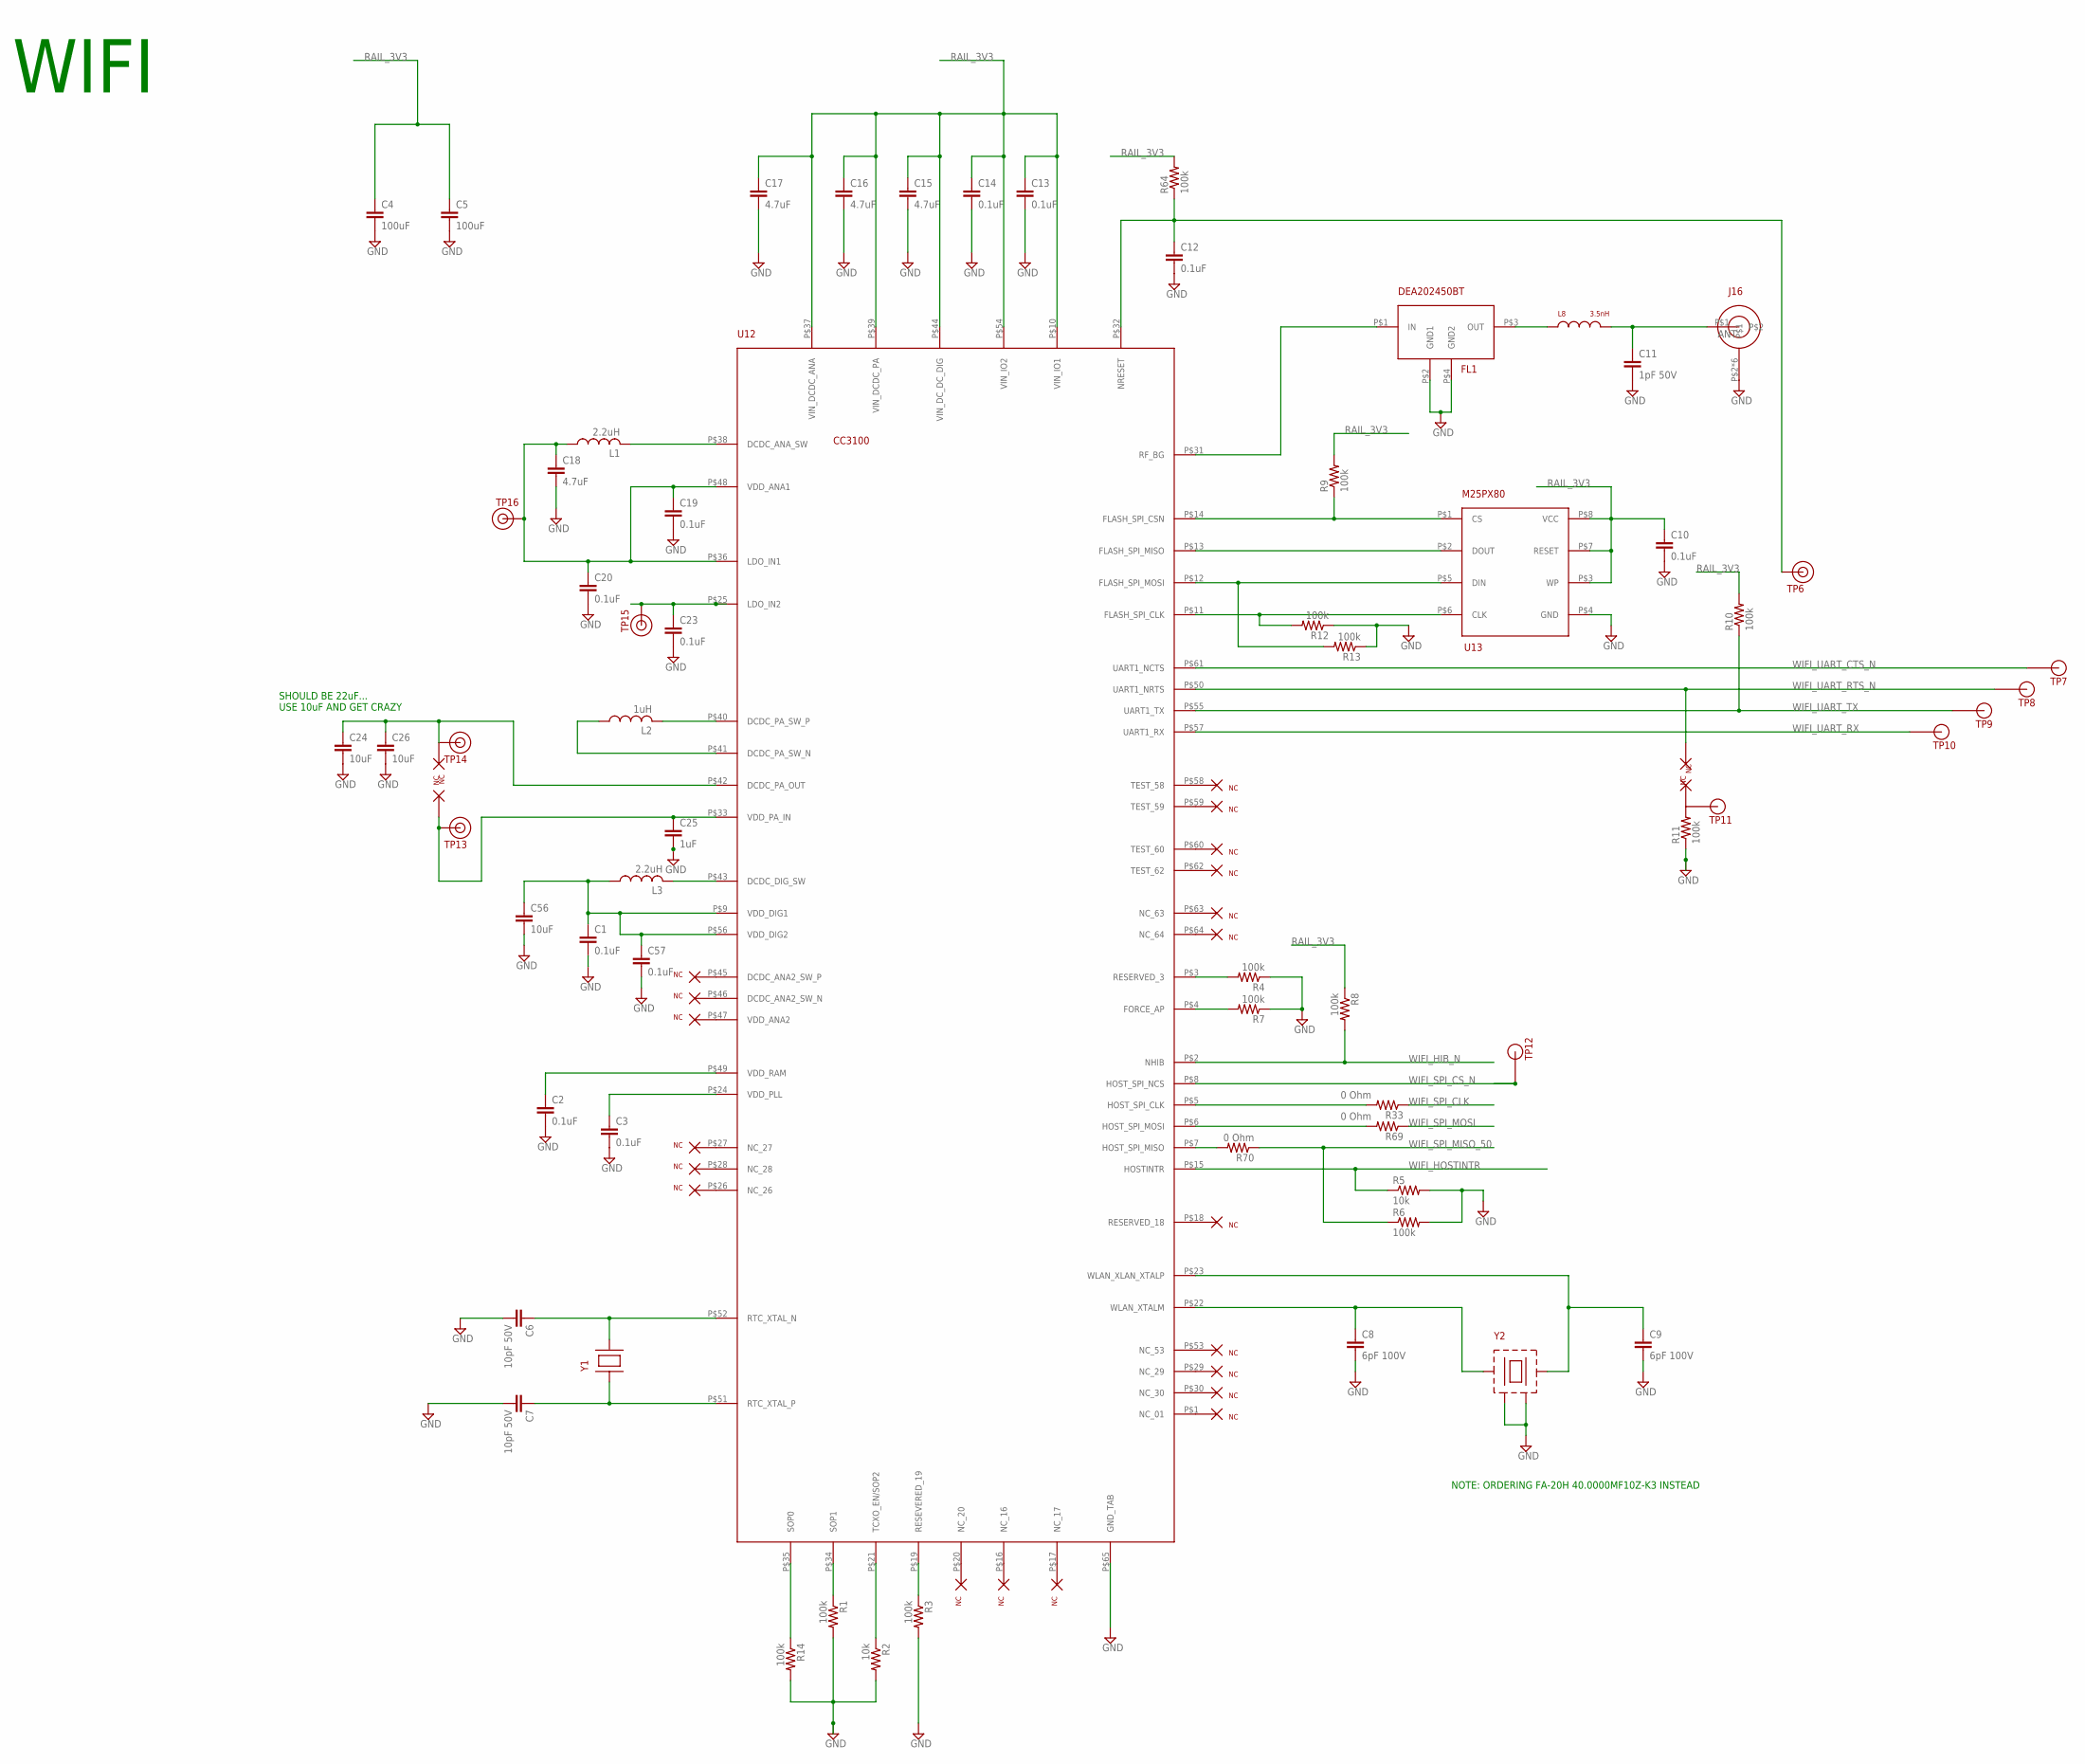
[picture p8: schematic ROVER_PCB.sch, sheet 4]

Parts:
C1, C3, C10, C12, C13, C14, C19, C20, C23, C57: 0.1uF; C0402
C2: 0.1uF; C0603
C4, C5: 100uF; C1206
C6, C7: 10pF 50V; C0402
C8, C9: 6pF 100V; C0402
C11: 1pF 50V; C0402
C15, C16, C17, C18: 4.7uF; C0402
C24, C26: 10uF; C0402
C25: 1uF; C0402
C56: 10uF; C0603
FL1: DEA202450BT
J16: SMA_CONNECTOR
L1, L3: 2.2uH; L1812
L2: 1uH; L1812
L8: 3.5nH; L0402
R1, R3, R4, R6, R7, R8, R9, R11, R12, R13, R14, R64: 100k; R0603
R2, R5: 10k; R0603
R10: 100k; R0402
R33, R69, R70: 0 Ohm; R0402
TP6, TP13, TP14, TP15, TP16: TEST_POINT
TP7, TP8, TP9, TP10, TP11, TP12: TP25MIL
U12: CC3100CORRECT_QFN; QFN64
U13: M25PX80; SO8N
Y1: ABS07-32.768KHZ-T
Y2: Q24FA20H00396

Connections:
ANT: C11.1, J16.P$1, L8.2
GND: C1.2, C2.2, C3.2, C4.2, C5.2, C6.2, C7.2, C8.2, C9.2, C10.2, C11.2, C12.2, C13.2, C14.2, C15.2, C16.2, C17.2, C18.2, C19.2, C20.2, C23.2, C24.2, C25.2, C26.2, C56.2, C57.2, FL1.P$2 (GND1), FL1.P$4 (GND2), J16.P$2, J16.P$3, J16.P$4, J16.P$5, J16.P$6, J16.P$7, R1.2, R2.2, R3.2, R4.1, R5.2, R6.2, R7.1, R11.1, R12.1, R13.1, R14.2, U12.P$65 (GND_TAB), U13.P$4 (GND), Y2.P$2, Y2.P$4; also elsewhere on the board
unnamed: C24.1, C26.1, TP14.P$1, U12.P$42 (DCDC_PA_OUT)
unnamed: C18.1, C19.1, C20.1, L1.1, TP16.P$1, U12.P$36 (LDO_IN1), U12.P$48 (VDD_ANA1)
unnamed: L3.2, U12.P$43 (DCDC_DIG_SW)
unnamed: C1.1, C56.1, C57.1, L3.1, U12.P$9 (VDD_DIG1), U12.P$56 (VDD_DIG2)
unnamed: C2.1, U12.P$49 (VDD_RAM)
unnamed: L1.2, U12.P$38 (DCDC_ANA_SW)
unnamed: L2.2, U12.P$40 (DCDC_PA_SW_P)
unnamed: L2.1, U12.P$41 (DCDC_PA_SW_N)
unnamed: C3.1, U12.P$24 (VDD_PLL)
unnamed: R14.1, U12.P$35 (SOP0)
unnamed: R1.1, U12.P$34 (SOP1)
unnamed: R2.1, U12.P$21 (TCXO_EN/SOP2)
unnamed: R3.1, U12.P$19 (RESEVERED_19)
unnamed: C8.1, U12.P$22 (WLAN_XTALM), Y2.P$1
unnamed: C9.1, U12.P$23 (WLAN_XLAN_XTALP), Y2.P$3
unnamed: C7.1, U12.P$51 (RTC_XTAL_P), Y1.P$1
unnamed: C6.1, U12.P$52 (RTC_XTAL_N), Y1.P$2
unnamed: R7.2, U12.P$4 (FORCE_AP)
unnamed: R4.2, U12.P$3 (RESERVED_3)
unnamed: R9.1, U12.P$14 (FLASH_SPI_CSN), U13.P$1 (CS)
unnamed: U12.P$13 (FLASH_SPI_MISO), U13.P$2 (DOUT)
unnamed: R13.2, U12.P$12 (FLASH_SPI_MOSI), U13.P$5 (DIN)
unnamed: R12.2, U12.P$11 (FLASH_SPI_CLK), U13.P$6 (CLK)
unnamed: FL1.P$1 (IN), U12.P$31 (RF_BG)
unnamed: FL1.P$3 (OUT), L8.1
unnamed: R11.2, TP11.P$1
unnamed: C25.1, TP13.P$1, U12.P$33 (VDD_PA_IN)
RAIL_3V3: C4.1, C5.1, C10.1, C13.1, C14.1, C15.1, C16.1, C17.1, R8.1, R9.2, R10.2, R64.2, U12.P$10 (VIN_IO1), U12.P$37 (VIN_DCDC_ANA), U12.P$39 (VIN_DCDC_PA), U12.P$44 (VIN_DC_DC_DIG), U12.P$54 (VIN_IO2), U13.P$3 (WP), U13.P$7 (RESET), U13.P$8 (VCC); also elsewhere on the board
U13: C23.1, TP15.P$1, U12.P$25 (LDO_IN2)
WIFI_HIB_N: R8.2, U12.P$2 (NHIB); also elsewhere on the board
WIFI_HOSTINTR: R5.1, U12.P$15 (HOSTINTR); also elsewhere on the board
WIFI_RESET_N_WIFI: C12.1, R64.1, TP6.P$1, U12.P$32 (NRESET)
WIFI_SPI_CLK: R33.1; also elsewhere on the board
WIFI_SPI_CLK_50: R33.2, U12.P$5 (HOST_SPI_CLK)
WIFI_SPI_CS_N: TP12.P$1, U12.P$8 (HOST_SPI_NCS); also elsewhere on the board
WIFI_SPI_MISO: R70.2, U12.P$7 (HOST_SPI_MISO)
WIFI_SPI_MISO_50: R6.1, R70.1; also elsewhere on the board
WIFI_SPI_MOSI: R69.1; also elsewhere on the board
WIFI_SPI_MOSI_50: R69.2, U12.P$6 (HOST_SPI_MOSI)
WIFI_UART_CTS_N: TP7.P$1, U12.P$61 (UART1_NCTS)
WIFI_UART_RTS_N: TP8.P$1, U12.P$50 (UART1_NRTS)
WIFI_UART_RX: TP10.P$1, U12.P$57 (UART1_RX)
WIFI_UART_TX: R10.1, TP9.P$1, U12.P$55 (UART1_TX)

Notes on the sheet:
WIFI
SHOULD BE 22uF... USE 10uF AND GET CRAZY
NOTE: ORDERING FA-20H 40.0000MF10Z-K3 INSTEAD

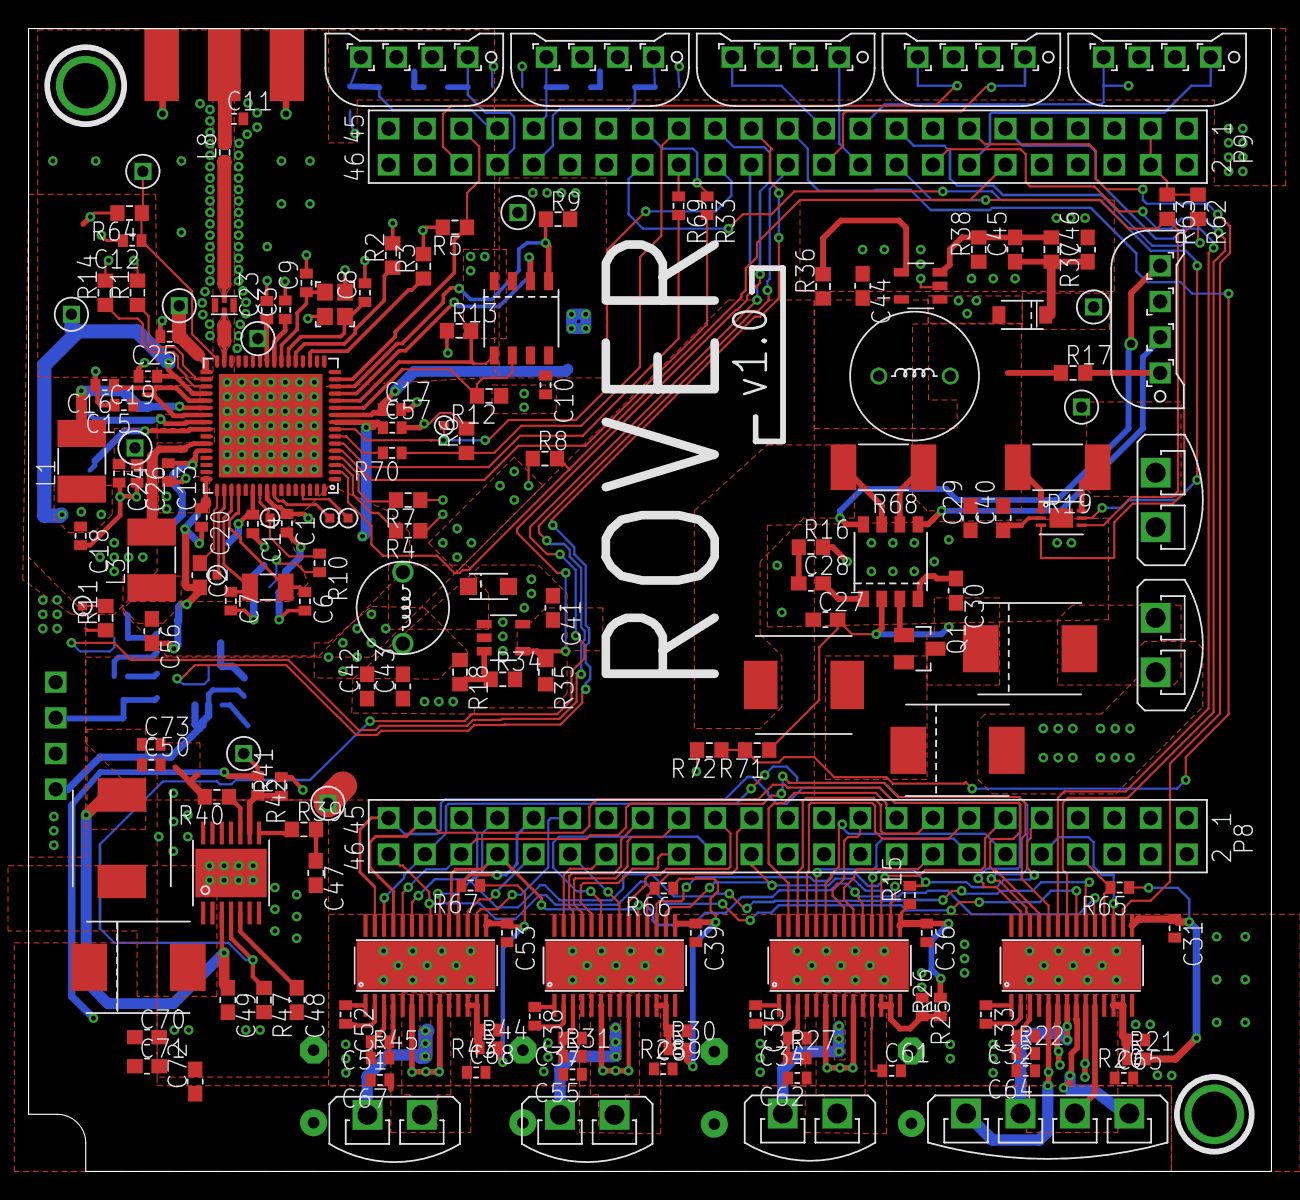
[picture p9: board ROVER_PCB.brd from above]

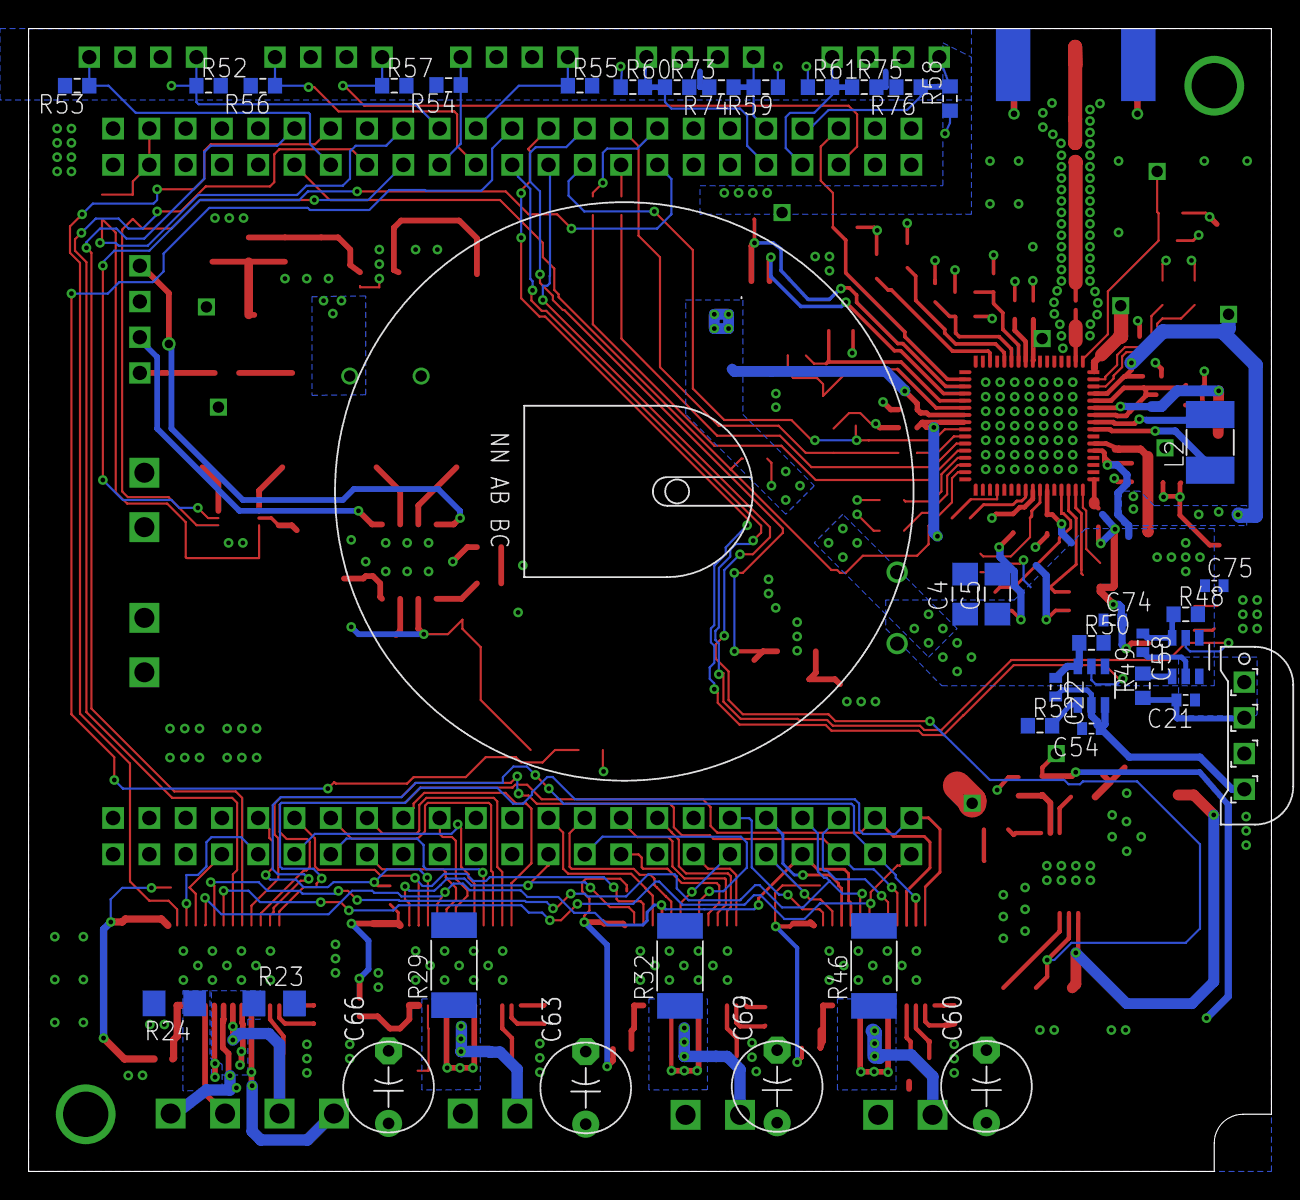
[picture p10: board ROVER_PCB.brd from below]

Board: 2 copper layers, 87.0 x 80.0 mm, 212 parts (39 on the bottom side), 164 nets.
