PetRover/board/(commit log)

2015-09-12 VC for schematic
    [ROVER_PCB.sch]
2015-09-14 learning git, updated some issues
    [ROVER_PCB.sch]
2015-09-15 fixed issue #9
    [ROVER_PCB.sch]
2015-09-16 updated some footprints. added library file. initial brd.
    [ROVER_PCB.brd]
2015-09-17 adding library and minor footprint updates
    [ROVER_PCB.sch]
2015-09-17 fixed footprint for DRV8842 and added solder mask defined thermal pad
2015-09-17 rearranged brd file. about 85% of it routes.
    [ROVER_PCB.brd, ROVER_PCB.sch]
2015-09-17 removed pins 32,58,71 on bbb and redistributed to nets removed from 3-7
    [ROVER_PCB.sch]
2015-09-17 updated component placement
    [ROVER_PCB.brd, ROVER_PCB.sch]
2015-09-18 motor drivers routed
    [ROVER_PCB.brd, ROVER_PCB.sch]
2015-09-18 routed 12V reg
    [ROVER_PCB.brd, ROVER_PCB.sch]
2015-09-19 routed 5v regulator and made a bunch of component footprint additions and imporvments
    [ROVER_PCB.brd, ROVER_PCB.sch]
2015-09-20 charging systems and all regulators routed. All footprints are done with mechanical outlines
    [ROVER_PCB.brd, ROVER_PCB.sch]
2015-09-21 began wifi routing
    [ROVER_PCB.brd]
2015-09-21 worked on part placement around wifi chip
    [ROVER_PCB.brd]
2015-09-22 fixed footprint of wifi chip
    [ROVER_PCB.brd, ROVER_PCB.sch]
2015-09-22 updated BBB footprint with proper numbers, mirrored BBB to gnd side of brd. updated part placement around wifi chip
    [ROVER_PCB.brd, ROVER_PCB.sch]
2015-09-23 wip commit
    [ROVER_PCB.brd, ROVER_PCB.sch]
2015-09-23 adding bom
    [ROVER_PCB_BOM.csv]
2015-09-24 wifi mostly routed
    [ROVER_PCB.brd, ROVER_PCB.sch]
2015-09-24 First pass at resistor, capacitor, and inductor values/digikey links
    [ROVER_PCB_BOM.csv]
2015-09-25 net names for BBB on schematic
    [ROVER_PCB.brd, ROVER_PCB.sch]
2015-09-25 Added more nets
    [ROVER_PCB.brd, ROVER_PCB.sch]
2015-09-28 everything placed... working on final signal traces
    [ROVER_PCB.brd, ROVER_PCB.sch]
2015-09-28 more WIP routing
    [ROVER_PCB.brd, ROVER_PCB.sch]
2015-09-29 More capacitors/resistors selected
    [ROVER_PCB_BOM.csv]
2015-09-29 WIP routing commit
    [ROVER_PCB.brd, ROVER_PCB.sch]
2015-09-29 more resistors/capacitors
    [ROVER_PCB_BOM.csv]
2015-09-29 WIP routing
    [ROVER_PCB.brd, ROVER_PCB.sch]
2015-09-30 trying to fix pour issue that alyssa is having
    [ROVER_PCB.brd]
2015-10-02 0 airwires, added silkscreen
    [ROVER_PCB.brd, ROVER_PCB.sch]
2015-10-03 gerbers generated
    [ROVER_PCB.brd, ROVER_PCB.sch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]
2015-10-04 OK2FAB check
    [ROVER_PCB.brd, ROVER_PCB.sch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]
2015-10-15 Forgot to press save - even more capacitors
    [ROVER_PCB_BOM.csv]
2015-10-15 A few more capacitors
    [ROVER_PCB_BOM.csv]
2015-10-15 more capacitors/indcutors
    [ROVER_PCB_BOM.csv]
2015-10-16 A few more resistors...getting there
    [ROVER_PCB_BOM.csv]
2015-10-16 Adding to schematic
    [ROVER_PCB_BOM.csv]
2015-10-17 THE BOM IS (BASICALLY) DONE
    [ROVER_PCB_BOM.csv]
2015-10-17 Fully updated schematic will all component values
    [ROVER_PCB.brd, ROVER_PCB.sch, Sense resistor calcs.xlsx]
2015-10-17 WIP commit before changing symbols
    [ROVER_PCB.brd, ROVER_PCB.sch, ROVER_PCB_BOM.csv]
2015-10-17 Changed to all US cap symbols
    [ROVER_PCB.sch]
2015-10-20 BOM working commit
    [FINAL_BOM.xls, MANUAL_PARTS_BOM.csv, PART_BOM_FROM_EAGLE.csv, REFDES_LINK_MAPPING.csv, ROVER_PCB.brd, ROVER_PCB.sch, ROVER_PCB_BOM.csv]
2015-10-20 Added 1% to critical resistors for identifcation
    [ROVER_PCB.brd, ROVER_PCB.sch]
2015-10-21 ready for final check
    [MANUAL_PARTS_BOM.csv, PART_BOM_FROM_EAGLE.csv, REFDES_LINK_MAPPING.csv, ROVER_PCB.brd, ROVER_PCB.sch]
2015-10-28 final commit of board (parts order and board fabbed)
    [FINAL_BOM(AUTO).csv, FINAL_BOM.xls, REFDES_LINK_MAPPING.csv, ROVER_PCB.brd, ROVER_PCB.sch, digikey_order.csv]
